mike-rankin/Shot-Core/Images/assembled_back_2.jpg

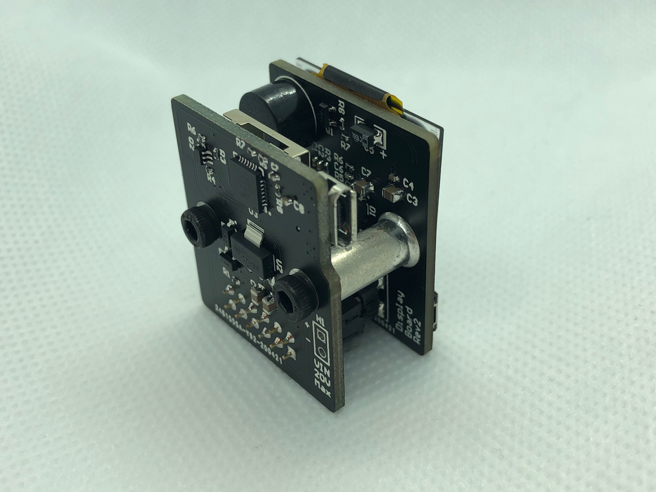
Images/assembled_back_2.jpg
