mike-rankin/Shot-Core/Images/assembled_back.jpg

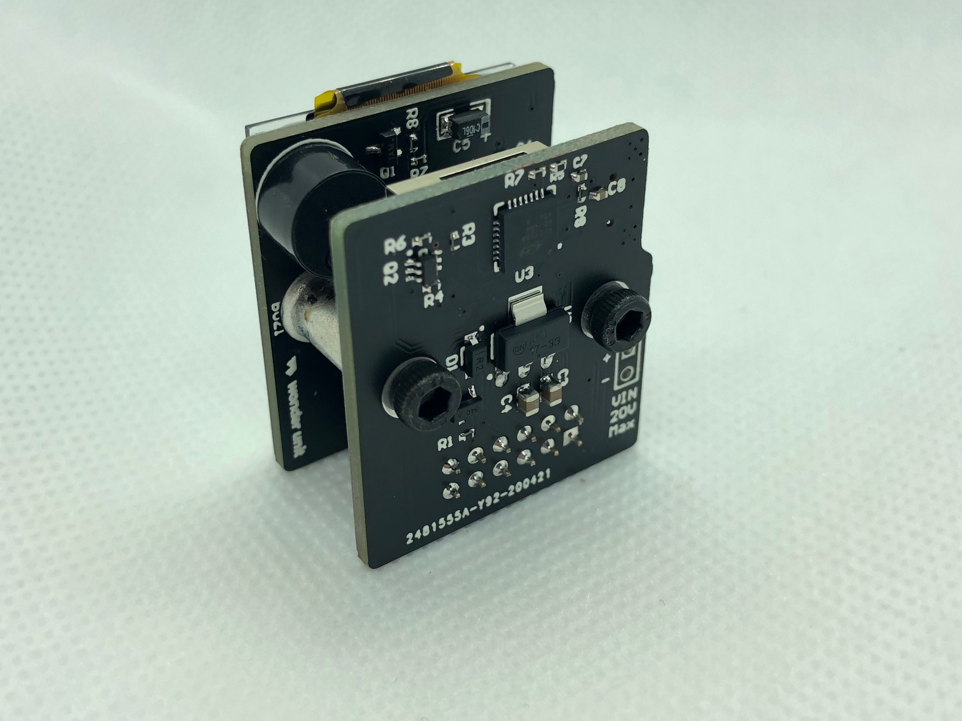
Images/assembled_back.jpg
