mike-rankin/Shot-Core/Images/display_1.jpg

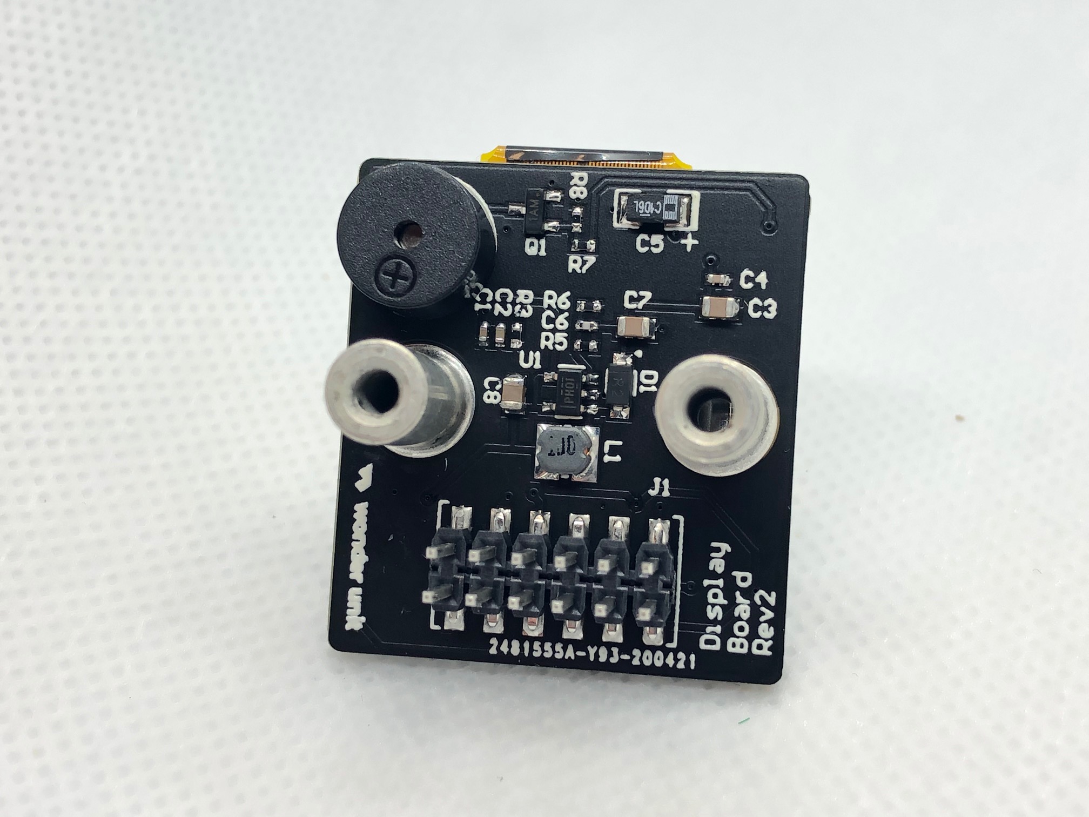
Images/display_1.jpg
