mike-rankin/Shot-Core/Images/display_2.jpg

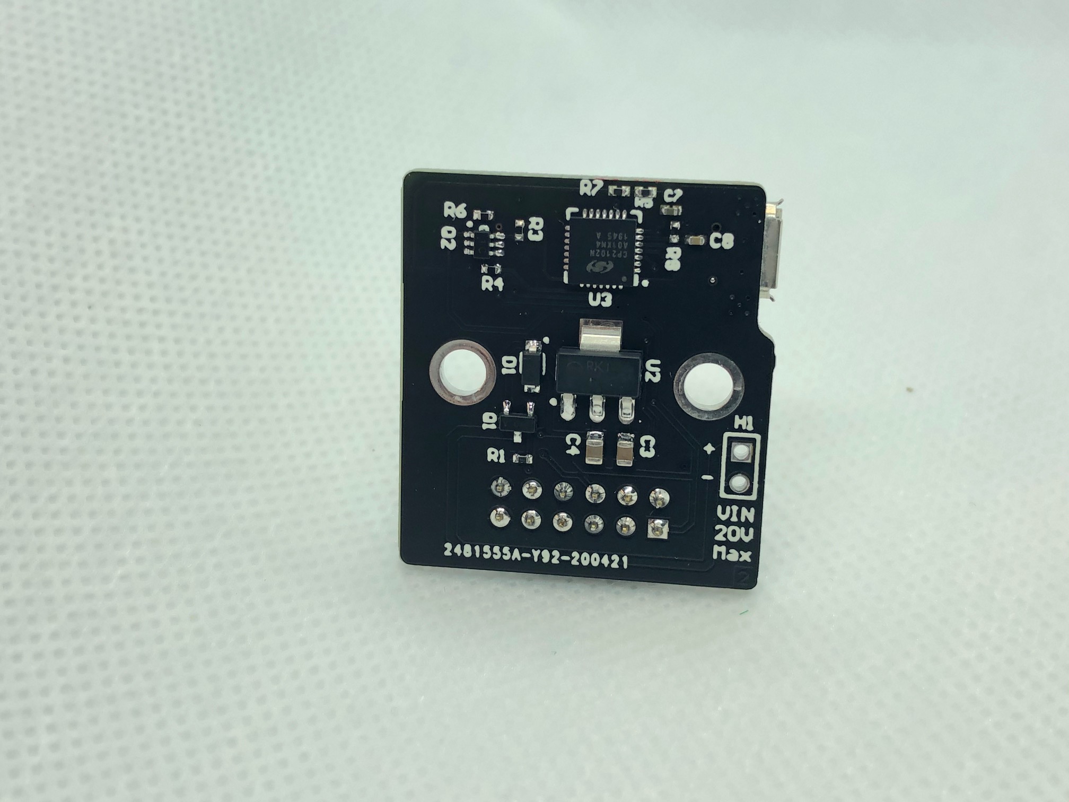
Images/display_2.jpg
