mike-rankin/Shot-Core/Images/esp_2.jpg

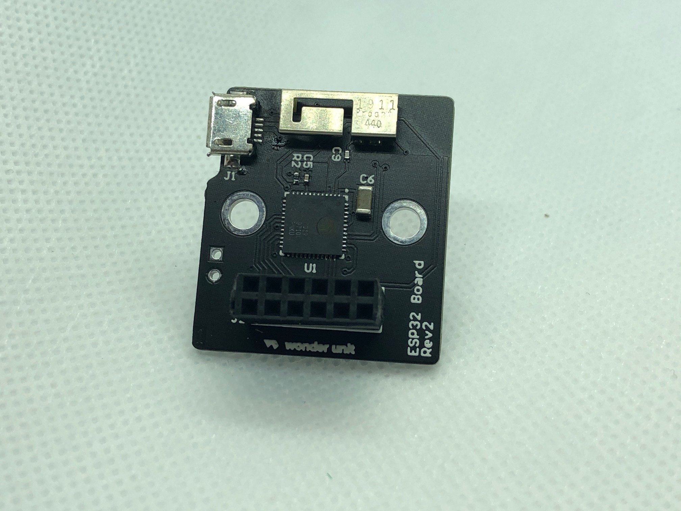
Images/esp_2.jpg
