mike-rankin/Shot-Core/Images/front_1.jpg

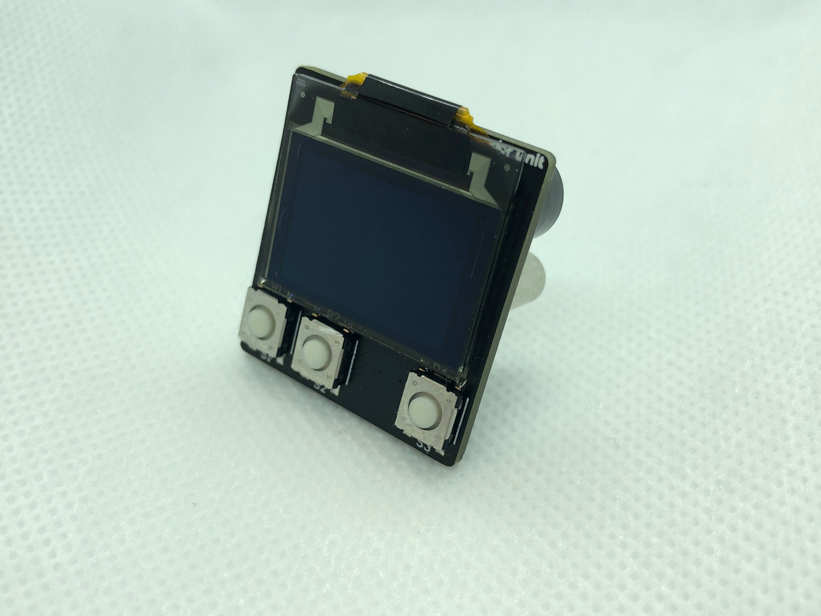
Images/front_1.jpg
