mike-rankin/Shot-Core/Images/stack_front.png

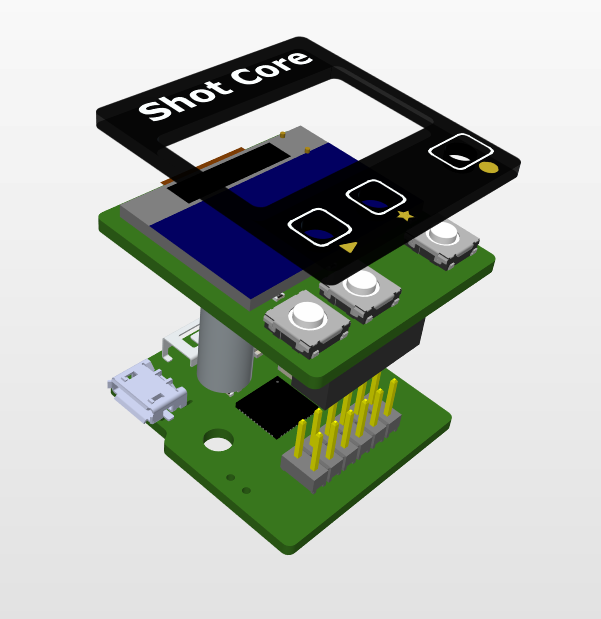
Images/stack_front.png
