mike-rankin/Shot-Core/PCBs/Display_PCB_BOM_Rev2.xlsx

Designator | Quantity | Vendor | Part_Number | Description | Manufacturer | Value
BUZ1 | 1 | LCSC | C96102 | BUZZER MAGNETIC 3V 9MM RADIAL | Jiangsu | Buzzer
C1, C4 | 2 | LCSC | C60474 | CAP 0.1uF 0402 | Yageo | 0.1uF
C2 | 1 | LCSC | C255498 | CAP 4.7uF 0402 | Kyocera | 4.7uF
C3, C7, C8 | 3 | LCSC | C162317 | CAP 10uF 0805 | Murata | 10uF
C5 | 1 |  | T491A475M025AT | 4.7µF 25V Tantalum 1206 | Kemet | 4.7uF Tant
C6 | 1 | LCSC | C1546 | CAP 0.1uF 50V 0402 | FH | 100pF
D1 | 1 | LCSC | C78746 | DIODE SCHOTTKY 20V 500MA SOD-123 | MCC | MBR0520
J1 | 1 | Digi-Key | SSW-106-22-L-D-VS | CONN,6x2,RECPT,VERT,SMD,0.100 | Samtec | CONN,6x2,RECPT,VERT,SMD,0.100
L1 | 1 | LCSC | C143260 | INDUCTOR 10uH 20% 760MA 3.5x2.1 | FH | 10uH
P1, P2 | 2 | Digi-Key | 9774130360R | STANDOFF, PCB,SMT,M3,13mm | Wurth | Standoff 13mm
Q1 | 1 | LCSC | C77991 | TRANSISTOR NPN GP 40V SOT23 | Micro Commercial | MMBT3904
R1, R2, R4, R8 | 4 | LCSC | C25744 | RES 10K 0402 | Uniroyal | 10K
R3 | 1 | LCSC | C270418 | RES 1.2M 0402 | Uniroyal | 1.2M
R5 | 1 | LCSC | C26087 | RES 1M 0402 | Uniroyal | 1M
R6 | 1 | LCSC | C270571 | RES 95.3K 0402 | Uniroyal | 95.3K
R7 | 1 | LCSC | C11702 | RES 1K 0402 | Uniroyal | 1K
S1, S2, S3 | 3 | Digi-Key | EVQ-Q2K02W | SWITCH TACTILE SPST-NO | Panasonic | Tactile PushButton SMT
U1 | 1 | LCSC | C7722 | IC LED DRVR WHITE BCKLGT SOT23-5 | Texas Instruments
X1 | 1 | Buy-Display | ER-OLED0.95-2C | 0.95 INCH OLED GLASS COLOR | Buy-Display | Color Oled 96x64
