mike-rankin/Shot-Core/PCBs/ESP32_PCB_BOM_Rev2.xlsx

Designator | Quantity | Vendor | Part_Number | Description | Manufacturer | Value
ANT1 | 1 | Digi-Key | PRO-OB-440 | RF ANT 2.4GHZ STAMPED MET SLD | Proant AB | RF ANT 2.4GHZ STAMPED MET SLD
C3, C4 | 2 | LCSC | CL21A106KOQNNNG | CAP 10uF 0805 | Samsung | 10uF
C5 | 1 | LCSC | C60474 | CAP 0.1uF 0402 | Yageo | 0.1uF
C6 | 1 | LCSC | JMK316BJ107ML-T | CAP 100uF 6.3V 1206 | Taiyo Yuden | 100uF
C7 | 1 | LCSC | 0402X105K160 | CAP 1uF 16V 0402 | Walsin | 1uF
C8 | 1 | LCSC | CM05X5R475M16AH | CAP 4.7uF 16V 0402 | Kyocera | 4.7uF
C9 | 1 | LCSC | C147344 | CAP 1.5pF 0402 | Dafron | 1.5pF
D1 | 1 | LCSC | C78746 | DIODE SCHOTTKY 20V 500MA SOD-123 | MCC | MBR0520
J1 | 1 | LCSC | C21377 | CONN RECPT MICRO USB | Boom Precision | Micro USB
J2 | 1 | Digi-Key | TSW-106-07-L-D | HDR,6X2,VERT,TH,0.100 | Samtec | 6x2 Male Thru-hole
Q1 | 1 | LCSC | C75469 | MOSFET P-CH 20V 2A SOT-23 | On Semi | Mosfet P-CH
Q2 | 1 | LCSC | BC847S | TRANS 2NPN 44V 0.1A SC-70-6 | Changjiang | 2NPN
R1 | 1 | LCSC | 0402WGF1003TCE | RES 100K 0402 | Uniroyal Elec | 100K
R2, R3, R4, R6 | 4 | LCSC | C25744 | RES 10K 0402 | Uniroyal | 10K
R5 | 1 | LCSC | RC0402FR-0722K1L | RES 22.1K OHM 0402 | Yageo | 22.1K
R7 | 1 | LCSC | RC0402FR-0747K5L | RES 47.5K 0402 | Yageo | 47.5K
R8 | 1 | LCSC | RC0402FR-074K7L | RES 4.7K OHM 0402 | Yageo | 4.7K
U1 | 1 | LCSC | C193707 | WIFI/Bluetooth, QFN-48 7x7 | Espressif | ESP32-PICO-D4
U2 | 1 | LCSC | C26537 | IC REG LDO 1.0A 3.3V SOT-223 | On Semi | 3.3V LDO
U3 | 1 | LCSC | C428937 | IC BRIDGE USB TO UART 28QFN | Silicon Labs | CP2102N
