mike-rankin/Shot-Core/PCBs/Display_PCB_Rev2.pdf

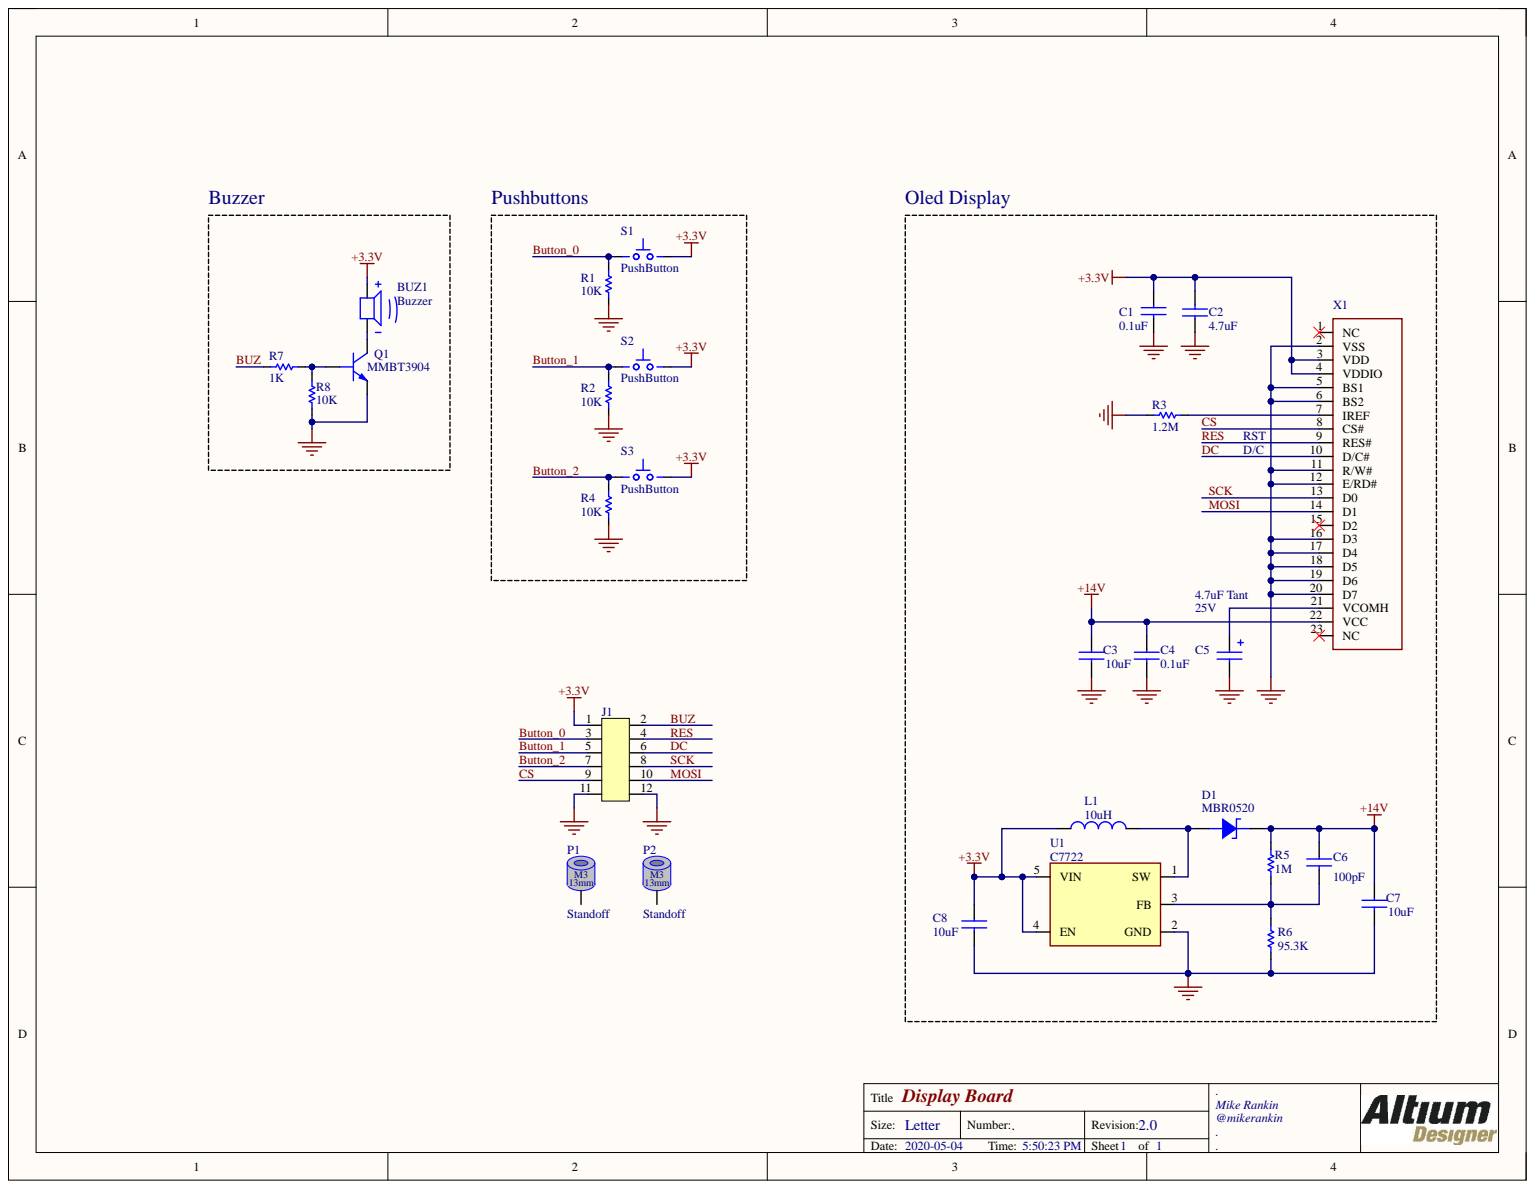
[picture p8: page 1]
