mike-rankin/Shot-Core/PCBs/ESP32_PCB_Rev2.pdf

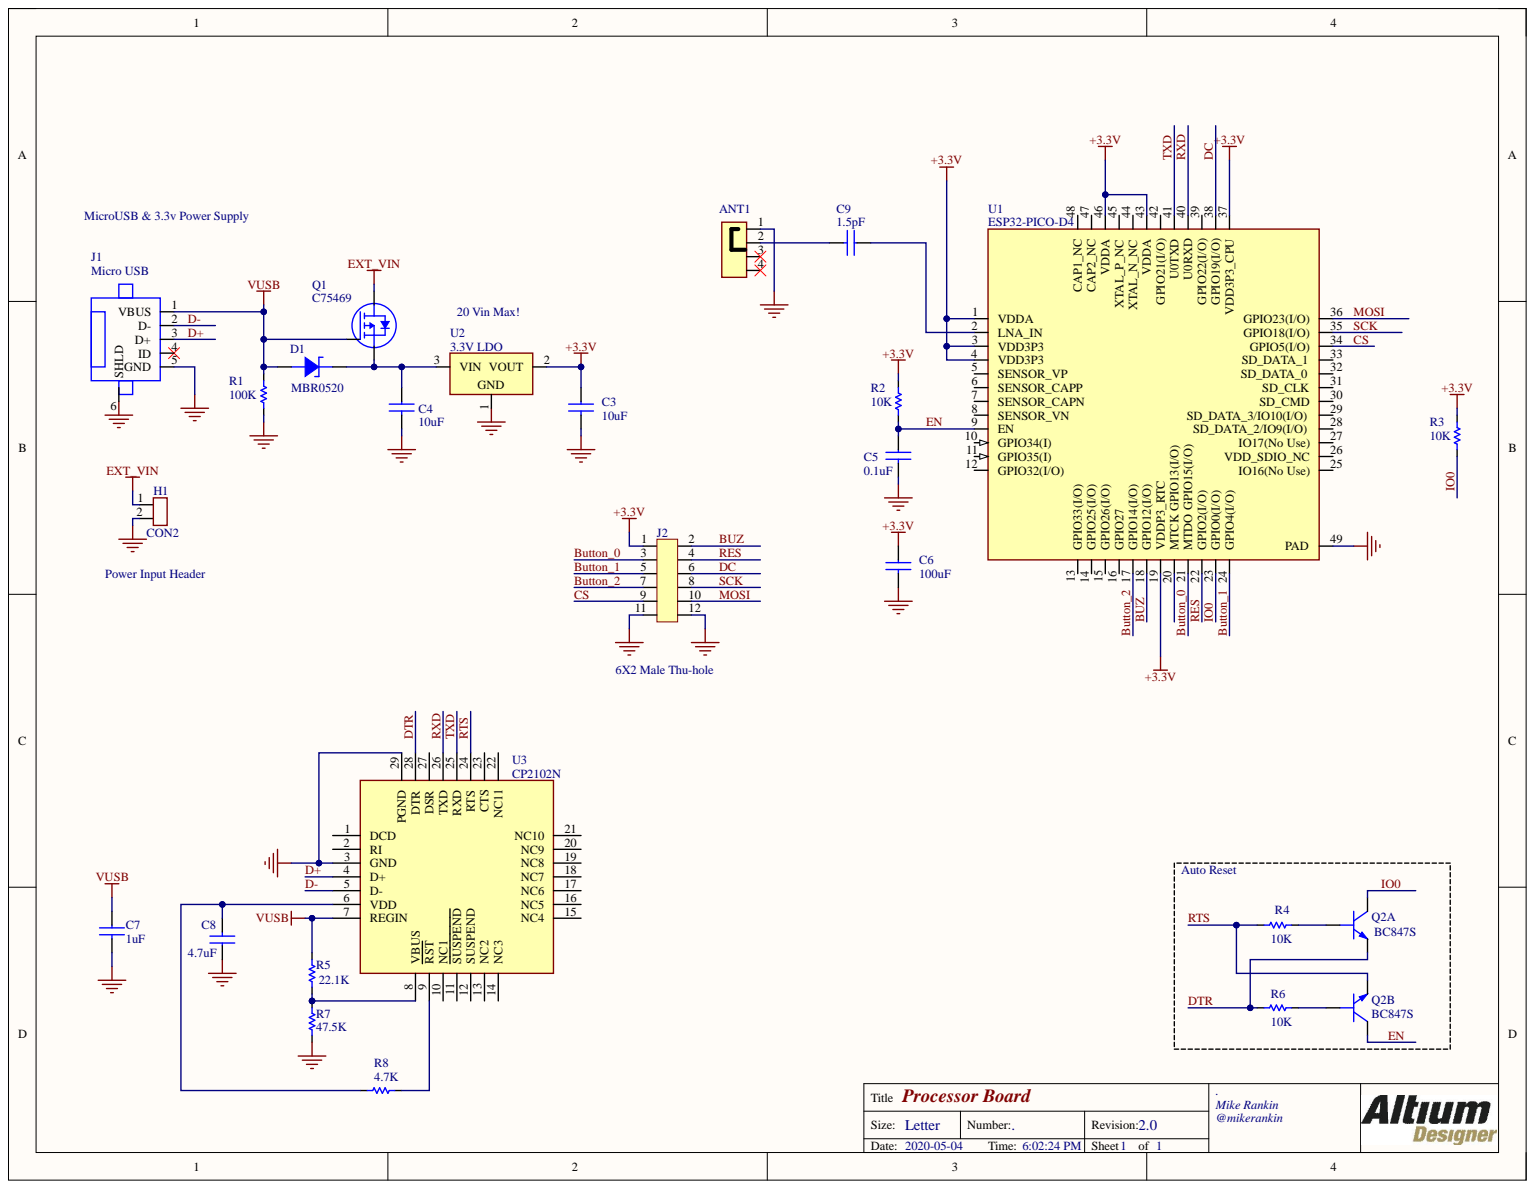
[picture p9: page 1]

GPIO4(I/O) 24 IO16(No Use) 25 VDD_SDIO_NC 26 IO17(No Use) 27 SD_DATA_2/IO9(I/O) 28 SD_DATA_3/IO10(I/O) 29 SD_CMD 30 SD_CLK 31 SD_DATA_0 32 SD_DATA_1 33 GPIO5(I/O) 34 GPIO18(I/O) 35 GPIO23(I/O) V

NC11 22 CTS 23 RTS 24 RXD 25 TXD 26 DSR 27 DTR 28 PGND 29
