mike-rankin/Shot-Core/Images/assembled_front.jpg

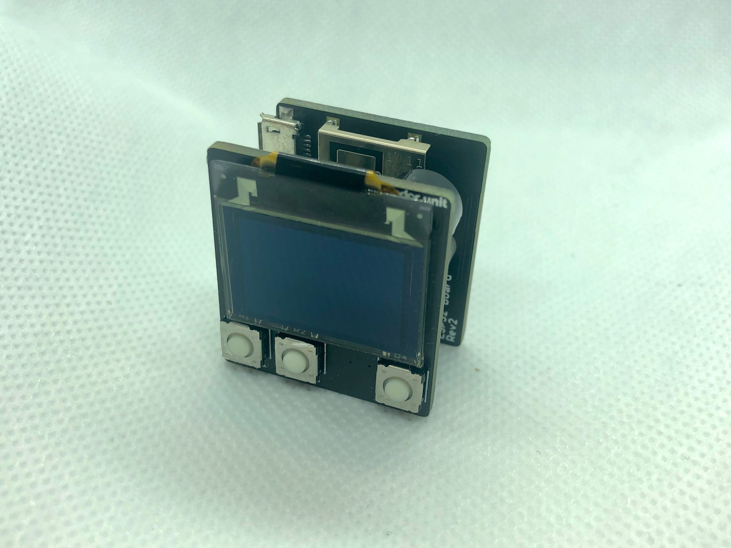
Images/assembled_front.jpg
